veproza/Synchronizovana-kinematicka-mereni/sources/rf433-tx.ino

void setup() {
  pinMode(12, OUTPUT);
  pinMode(13, OUTPUT);
}

void loop() {
  digitalWrite(12, HIGH);
  digitalWrite(13, HIGH);
  delay(50);
  digitalWrite(12, LOW);
  digitalWrite(13, LOW);
  delay(50);
}
